FarahnazAzimi/Blue-Arm/Documentation/Blue_Arm_Report.pdf

به نام خداوند بخشنده ی مهربان

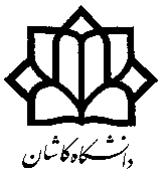
[picture p2: figure]

گزارش پروژه ی کارشناسی

## طراحی، ساخت و کنترل بازوی رباتیک

## مفصل سه درجه آزادی با قابلیت کنترل بی سیم (RRR(

Blue Arm project

- تهیه کننده : فرحناز عظیمی
- شماره دانشجویی : 40121010043
- تاریخ تحویل : 25 / /06 1405
- استاد راهنما : دکتر علیرضا فرجی
- راه ارتباطی از طریق ایمیل : com.gmail@222farahnazazimi
- راه ارتباطی از طریق ایتا : 222FARAHNAZAZIMI@

چکیده

این گزارش فرآیند طراحی، ساخت، کالیبراسیون و کنترل یک بازوی رباتیک مفصل سه درجه آزادی از نوع RRR را شرح میدهد . برخالف بسیاری از پروژه های مشابه که بر شبیه سازی تئوری تمرکز دارند این پروژه بر ساخت واقعی سخت افزار و کالیبراسیون تجربی با ابزار واقعی و چندین روش توسعه ی متفاوت سیمی و بی سیم ( wifi و Bluetooth )تمرکز دارد. بازو با سه سروو 995MG و یک گیرنده نهایی90SG ساخته شده و در نهایت به طور کامل توسط یک میکروکنترلر 32ESP کنترل میشود .معادالت سینماتیک معکوس و مستقیم استخراج شده و سپس با اندازه گیری دقیق ر وی ربات واقعی کالیبره شده اند تا خطای باقی مانده به حدود یک تا سه سانتی متر در عملیات برداشتن و گزاشتن (place and pick( واقعی برسد .بررسی

دینامیکی الگرانژی نیز توضیح میدهد که چرا مفصل شانه در وضعیت نزدیک به افقی بیشترین گشتاور را تجربه کند.

فهرست مطالب

چک ی ده 3 |
فصل 1 : مقدمه 6 |
فصل 2 : مرور ی بر منابع علم ی 7 |
فصل 3 : طراح ی و ساخت سخت افزار 9 |
فصل 4 : س ی نمات ی ک مستق ی م و معکوس 11 |
فصل 5 :تحل ی ل د ی نام ی ک ی به روش الگرانژ 18 |
فصل 6 : معمار ی نرم افزار ی و ارتباطات 23 |
23 | ۶.۱ firmware ESP32

فصل 7 : کال ی براس ی ون ، آزما ی ش و نتا ی ج 27 |
فصل 8 : چالش ها ی فن ی و روش ع ی ب ی اب ی 28 |
فصل :۹ نت ی جه گ ی ر ی و پ ی شنهاد ها 29 |
مراجع 30 |
آرش ی و تصاو ی ر 31 |

فصل 1 : مقدمه

### ۱.۱ انگیزه و اهمیت موضوع

بازوهای رباتیک مفصل یکی از پرکاربردترین انواع ربات در صنعت و آموزش هستند، زیرا فضای کاری بزرگ و انعطاف پذیری باالیی نسبت به حجم فیزیکی خود ارائه می دهند .ساخت یک نمونه کوچک و کم هزینه از این نوع ربات، فرصتی عملی برای درک عمیق مفاهیم سینماتیک، دینامیک، کنترل موتور و ارتباطات بی سیم فراهم می کند .

### ۱.۲ اهداف پروژه

- ساخت فیزیکی یک بازوی رباتیک سه درجه آزادی با سرووموتور
- استخراج و پیاده سازی معادالت سینماتیک مستقیم و معکوس
- کالیبراسیون واقعی ربات با اندازه گیری فیزیکی به جای اتکا صرف به مقادیر طراحی
- پیاده سازی سه روش کنترل ی مستقل: س یمی و بی س یم WiFi، و بلوتوث
- تحلیل دینامیکی برای درک نیاز گشتاوری هر مفصل
- رسیدن به قابلیت برداشتن و گذاشتن واقعی با دقت قابل قبول (Place and Pick(

### ۱.۳ ساختار گزارش

این گزارش با مروری بر پژوهش های مشابه آغاز می شود، سپس به ترتیب به طراحی سخت افزار، استخراج معادالت سینماتیک و دینامیک، معماری نرم افزاری و ارتباطات، فرآیند کالیبراسیون و آزمایش، چالش های فنی مواجه شده، و در نهایت نتیجه گیری و پیشنهادها می پردازد.

فصل 2 : مروری بر منابع علمی

پیش از آغاز ساخت، پژوهشهای مرتبط با بازوهای رباتیک سه درجه آزادی و روش های کنترل بی سیم آنها بررسی شد تا از تکراری نبودن مسیر و انتخاب رویکردهای معتبر اطمینان حاصل شود.

طهطاوی و آگن ی )۲۰۲۱( ی ک بازو ی رباتیک کوچک مقی اس سه درجه آزادی برا ی وظایف برداشتن و گذاشتن طراحی کردند که در آن معادالت س ینماتیک معکوس به صورت تحلیل ی استخراج و روی سخت افزار واقع ی پیادهسازی شده بود؛ نتایج آنها نشان داد که دقت موقع یت یابی به شدت به کالیبراس یون فیز یکی سرووها وابسته است، موضوعی که در پروژه حاضر نیز به وضوح تجربه شد

چن و همکاران )2025( در نشریه ی sensors یک بازو ی رباتیک دوتایی کم هز ینه با پیکربند ی سه درجه ازادی معرف ی کردند که تمرکز اصلی آن بر استفاده از قطعات ارزان قیمت بدون افت چشمگ یر دقت عملکردی بود رویکرد ی که با انتخاب سرووهایی 995MG و 90SG در این پروژه هم راستا هستند .

منتشر شده، یک بازوی برداشتن و گذاشتن مبتنی بر (۲۰۲۴) ResearchGate در پژوهشی دیگر که در سروو با تمرکز بر پیاده سازی عملی سینماتیک معکوس بررسی شده است که مشابه رویکرد فصل چهارم این برای بازوی دو پیوندی استفاده می کند (Cosines of Law (گزارش، از روش حل مثلثاتی .

در مقاله »طراحی بازوی ربات ی ک سه درجه آزاد ی« ) ۲۰۱۸(، فرمان و همکاران یک بازو ی مفصل صنعتی را با تمرکز بر انتخاب موتور بر اساس تحلیل گشتاور طراحی کردند؛ نتی جه گیری آن ها که »بی شترین گشتاور مورد نیاز موتور شانه در وضعیت افقی رخ می دهد« دقی قاً با یافته های فصل پنجم این گزارش )تحل یل دینامیک الگرانژ( و همچنین با تجربه واقعی خراب ی سروو شانه در ای ن پروژه هم خوانی دارد.

پاولوی و همکاران )۲۰۲۴( پی اده سازی کنترل یک بازوی رباتیک چهار درجه آزاد ی از طریق 32ESP و بلوتوث را گزارش کرده اند . این پژوهش به طور مستق یم مرتبط با فصل ششم این گزارش است، زیرا هر دو پروژه از 32ESP به عنوان واحد کنترل بی س یم بدون نیاز به رایانه واسط استفاده م ی کنند، هرچند در این پروژه عالوه بر بلوتوث، ارتباط WiFi و ی ک صفحه وب کنترلی نی ز اضافه شده است.

### ۲.۱ جمع بندی و جایگاه این پروژه

مرور منابع نشان می دهد که چالشهای اصلی این نوع پروژه ها )کالیبراس یون ف یزیکی، انتخاب مناسب موتور بر اساس گشتاور، و پیاده سازی ارتباط بی س یم پایدار( موضوعاتی شناخته شده در ادبیات هستند . نقطه تمایز این پروژه، ترکیب هر سه روش ارتباطی )س یمی، WiFi، بلوتوث( در یک س یستم واحد و مستند سازی کامل فرآیند کال یبراس یون تجربی گام به گام است.

فصل 3 : طراحی و ساخت سخت افزار

### ۳.۱ اجزای اصلی

نقش مشخصات قطعه

چرخش پایه حول محور عمودی 995MG سروو پایه

باال و پایین بردن بازوی باالیی 995MG سروو شانه

خم کردن ساعد نسبت به بازوی باالیی 995MG سروو آرنج

باز و بسته کردن گیرنده 90SG سروو گیرنده

تغذیه پایدار سرووها با جریان کافی (ATX (پاور کامپیوتر ۳۵۰ وات منبع تغذیه

کنترل مستقل بدون نیاز به رایانه (Bluetooth + WiFi (32ESP واحد کنترل

### ۳.۲ تکامل معماری سخت افزاری

در ابتدای پروژه از یک آردوینو uno برا ی کنترل مستق یم سرووها استفاده شد و 32ESP صرفاً به عنوان پل ارتباطی WiFi عمل می کرد. پس از آزمایش، مشخص شد که سرووهای معمولی )از جمله 995MG )با ولتاژ منطق ی ۳.۳ ولت 32ESP نیز به درستی کار می کنند، بنابراین آردوینو به طور کامل حذف شد و 32ESP به تنهایی مسئولی ت تولید س یگنال PWM برای هر چهار سروو، میزبانی صفحه وب، و مد یریت ارتباط بلوتوث را بر عهده گرفت. این تصمی م پیچیدگ ی س ی ستم را کاهش داد و امکان تغذ یه کامل ربات از یک منبع واحد )بدون نیاز به رایانه( را فراهم کرد. نکته ی مهم این است که با وجود سرووی چهارم، ربات ۴ درجه آزادی نیست.
* تعر یف درجه آزاد ی در بازو : درجات آزاد ی یک بازو ی رباتیک )Manipulator )بر اساس تعداد مفاصل مستقلی تعیین می شود که موقعیت )z ,y ,x )و جهت گیر ی ابزار را در فضای کاری مشخص می کنند .

* نقش سرووی چهارم: سه سرووی اول )پایه، شانه و آرنج( وظی فه جا به جایی و قرار دادن نوک بازو در مختصات مورد نظر را بر عهده دارند .

* حرکت پنجه/گیرنده یک حرکت داخلی برای ابزار نهایی )Effector End )است و مفصل جد ید ی به زنجیره س ینماتیکی اصلی بازو برای تغییر موقعیت در فضا اضافه نمی کند .

### ۳.۳ مسئله ی ظرفیت جریان برد بورد

در حین آزمایش هم زمان هر چهار سروو، مفصل شانه دچار ضعف و لرزش غیرمنتظره شد . بررس ی گام به گام نشان داد که علت اصلی، ظرفیت جریان محدود اتصاالت برد بورد بود، نه مشکلی در خود سروو یا کد؛ هر تماس فنری برد بورد معموالً ظرفیت قابل اطمینانی در حدود ۱ آمپر دارد که برای تغذ ی ه هم زمان چند سروو کافی نیست. راه حل نهایی، انتقال کامل مسیر تغذ یه به ی ک برد سوراخ دار لحیم شده )Perfboard )بود که مقاومت مسیر را به شدت کاهش داد.

### ۳.۴ تغذیه ی پایدار

منبع تغذ یه ATX با استفاده از روش اتصال کوتاه پایه ON_PS به زمین فعال شد . ولتاژ خروجی ۵ ولت با استفاده از ی ک LED و مقاومت به صورت تجربی تأیید شد و در نهایت یک خازن الکترولیتی بزرگ )۲۲۰۰ میکروفاراد( برا ی کاهش افت لحظه ای ولتاژ هنگام حرکت هم زمان چند سروو اضافه شد .

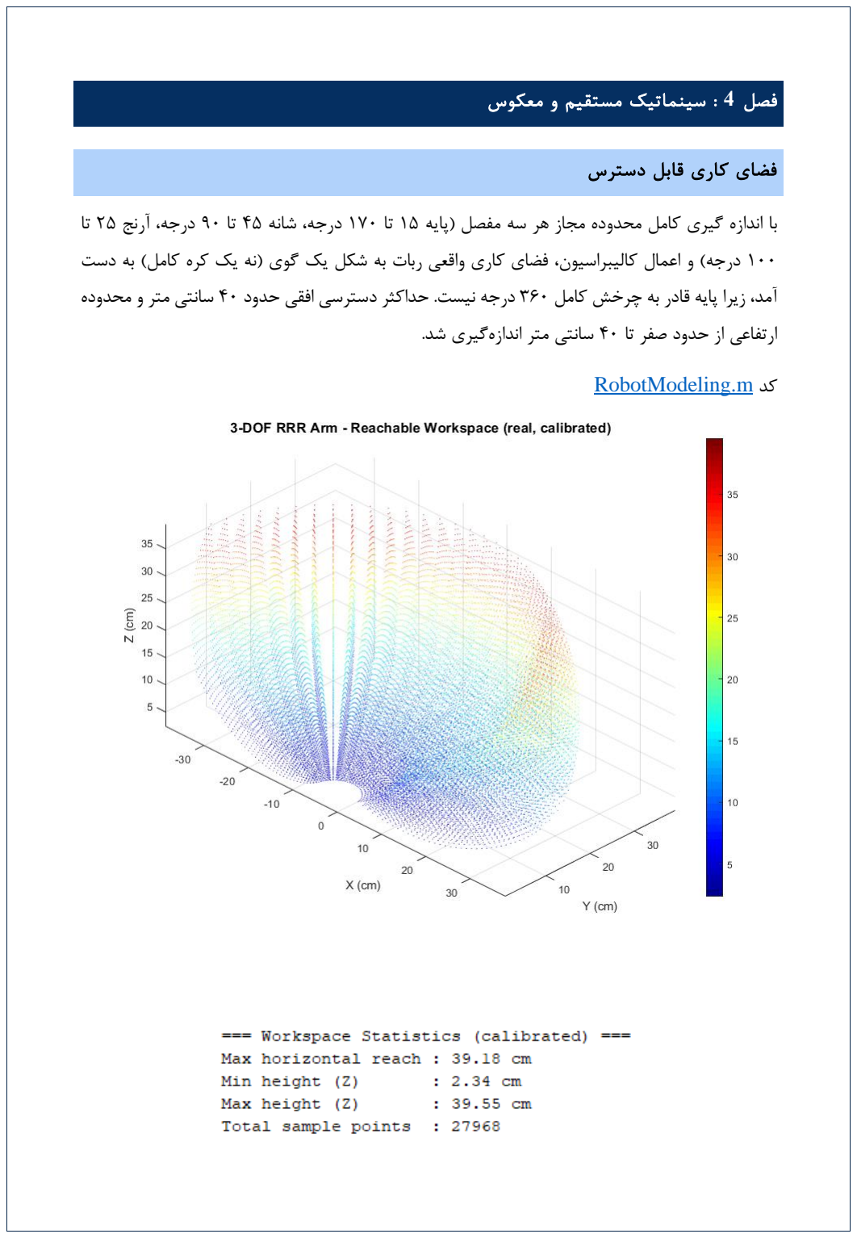
[picture p3: page 11]

فصل 4 : سینماتیک مستقیم و معکوس

فضای کاری قابل دسترس

با اندازه گیری کامل محدوده مجاز هر سه مفصل )پایه ۱۵ تا ۱۷۰ درجه، شانه ۴۵ تا ۹۰ درجه، آرنج ۲۵ تا ۱۰۰ درجه( و اعمال کالیبراس یون، فضای کاری واقعی ربات به شکل یک گو ی )نه ی ک کره کامل( به دست آمد، زی را پای ه قادر به چرخش کامل ۳۶۰ درجه نیست. حداکثر دسترس ی افقی حدود ۴۰ سانتی متر و محدوده ارتفاعی از حدود صفر تا ۴۰ سانتی متر اندازه گیری شد .

RobotModeling.m کد

### ۴.۱ پارامتر های هندسی واقعی

اندازه گیری مستقیم رو ی ربات ساخته شده )نه مقادیر طراحی اولیه ( برای دقت مدل ضروری بود، ز یرا براکت ها، شاخک سرووها و نگه دارنده گیرنده همگ ی طول واقعی بیشتری نسبت به طرح کاغذ ی ایجاد می کنند .

مقدار پارامتر

سانتی متر ۵ ارتفاع پایه از زمین

سانتی متر ۸ (پایه تا شانه) 1L

سانتی متر ۲۱ (شانه تا آرنج) 2L

سانتی متر ۲۸ )آرنج تا نوک گیرنده ( 3L

### DH parameter table

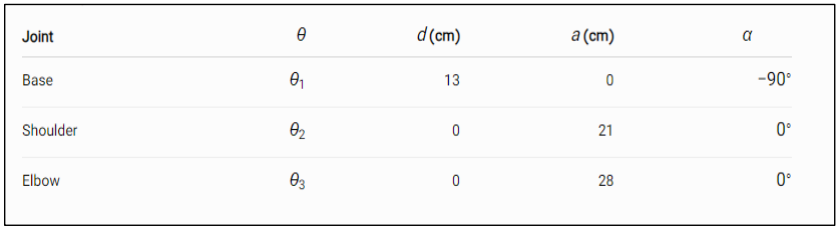
[picture p4: figure]

۴.۲ سینماتیک مستقیم (KINEMATICS FORWARD(

با استفاده از پارامترهای دناویت-هارتنبرگ ) DH )و همچنین معادالت بسته فرم مثلثاتی، موقعیت نوک گیرنده بر اساس زوایای مفاصل محاسبه می شود. قرارداد زاویه ای انتخاب شده به شرح زیر است:

- θ۱( پایه(: چرخش حول محور عمودی
- θ۲( شانه(: زاویه نسبت به افق
- θ۳( آرنج(: زاویه نسبی نسبت به بازوی باالیی )نه زاویه مطلق(

قرارداد زاویه نسبی آرنج از طریق آزمایش فیزیکی تأیید شد: با ثابت نگه داشتن شانه در دو زاویه مختلف و اندازه گیری زاویه واقعی ساعد با گونیا، مشخص شد که تغییر زاویه ساعد هم زمان با تغییر شانه جابه جا می شود، که این رفتار مشخصه یک مفصل نسبی است نه مطلق.

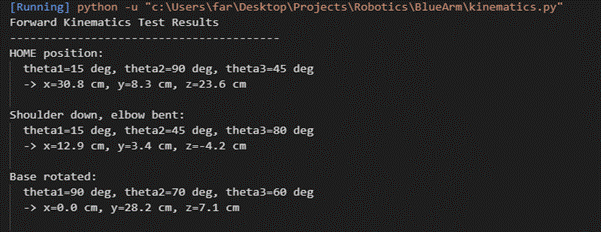
[picture p5: figure]

۴.۳ سینماتیک معکوس (KINEMATICS INVERSE(

برای یافتن زوایای الزم جهت رس یدن به ی ک نقطه هدف )z ,y ,x)، از روش حل مثلث ی بازوی دو پیوند ی ) قانون کسینوس ها( استفاده شد . این روش، زاویه داخلی آرنج را از روی فاصله مستقیم تا هدف محاسبه کرده و سپس زاویه شانه را با ترکیب زاوی ه مسیر مستق یم و زاویه کمکی به دست می آورد. الگوری تم پ یش از استفاده با ی ک آزمون رفت وبرگشت ) Test Trip-Round )اعتبارسنج ی شد : زوایای دلخواه ابتدا به یک موقعیت تبد یل شدند و سپس همان موقعیت مجدداً به زوایا بازگردانده شد؛ خطای این آزمون در حد ۰.۰۰۰۰۰۱ سانتی متر بود که نشان دهنده صحت ری اضی کامل معادالت است.

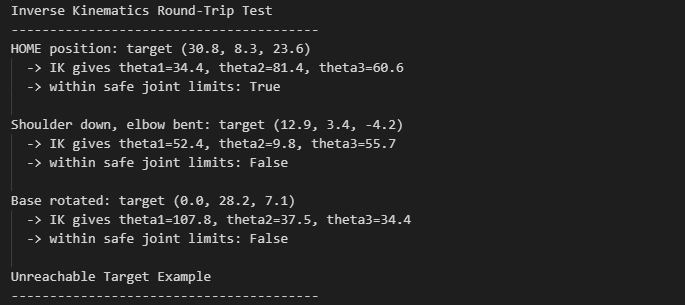
[picture p6: figure]

kinematics.py کد

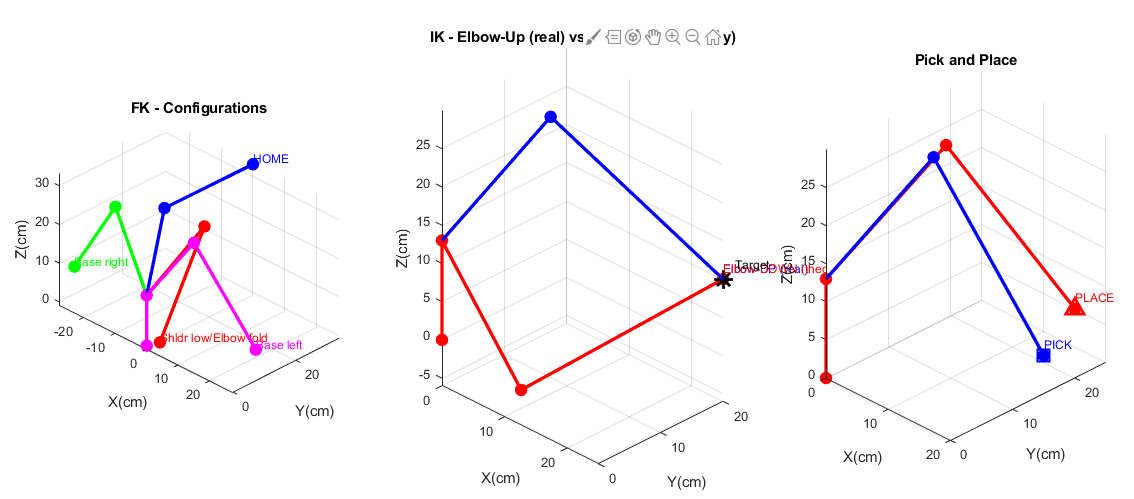
[picture p7: figure]

Kinematics_FK_IK.m کد

### Transformation matrices

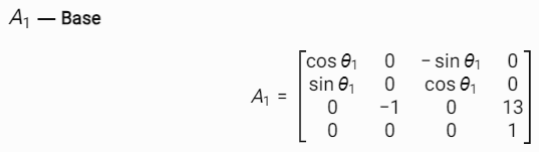
[picture p8: figure]
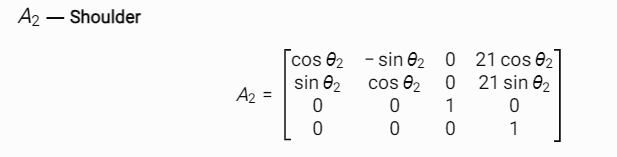
[picture p9: figure]
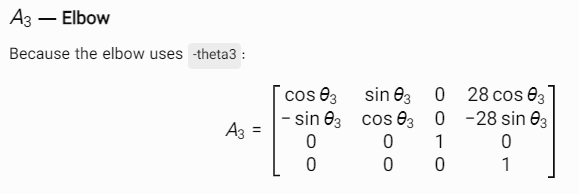
[picture p10: figure]

### Forward kinematics (FK)

T03 = A1 A2 A3 =

### end-effector position

### Inverse Kinematics (IK)

زاویه ی پایه :

فاصله ی افقی از پایه:

فاصله ی هدف از بازو:

برای قابل دسترس بودن :

برای این ربات :

### ۴.۴ کالیبراسیون تجربی

با وجود صحت ریاضی معادالت، اولین آزمایش رو ی ربات واقعی نشان داد که موقعیت واقعی گیرنده با موقعیت پیش بینی شده تا حدود ۹ تا ۱۰ سانتیمتر تفاوت دارد. علت این تفاوت، عدم تطابق دقی ق زاوی ه فرمانی سروو با زاویه واقعی مکانیکی مفصل بود )ناش ی از نحوه نصب شاخک سروو(. با اندازه گیر ی مستق یم زاویه واقعی توسط گونیا در چند نقطه مشخص و برازش خط ی، مقادی ر جبرانی زیر به دست آمد :

مقدار پارامتر جبرانی

درجه ۱۵.۵ جبران زاویه شانه

درجه ۴۹.۷ جبران زاویه آرنج

سانتی متر -۵ X تصحیح موقعیت

سانتی متر +۴ Y تصحیح موقعیت

سانتی متر -۷ Z تصحیح موقعیت

پس از اعمال این تصحیحات، خطای موقعیت یابی در آزمایشهای واقعی برداشتن-گذاشتن به حدود ۲ تا ۳ سانتی متر کاهش یافت که برای وظایف عملی این ربات قابل قبول ارزیابی شد .

فصل 5 :تحلیل دینامیکی به روش الگرانژ

### ۵.۱ هدف تحلیل

در حالی که سینماتیک مشخص می کند ربات کجا قرار دارد، دینامیک مشخص می کند هر موتور برای نگه داشتن یا حرکت دادن بازو به چه میزان گشتاور نیاز دارد .این تحلیل به طور مستقیم یک مشکل واقعی این پروژه را توضیح می دهد :سروو شانه در وضعیت نزدیک به افقی دچار فشار مکانیکی شد و نیاز به تعویض پیدا کرد.

روش 5.2

با استفاده از مکانیک الگرانژی، انرژی جنبشی و پتانسیل هر پیوند بر اساس مرکز جرم آن محاسبه و معادله حرکت استاندارد رباتیک به دست آمد :

M(q)·q̈ + C(q,q̇)·q̇ + G(q) = τ

که در آن M ماتریس اینرسی، C ماتریس کوریولیس/گریز از مرکز، G بردار گشتاور گرانشی، و τ گشتاور مورد نیاز هر مفصل است. از آنجا که این بازو با سرعت پایین حرکت می کند، مؤلفه گرانشی (G (نقش غالب را ایفا می کند .

جرمهای تخمینی ربات به شکل زیر در نظر گرفته شده اند :

- m1 = 0.500 kg
- m2 = 0.300 kg
- m3 = 0.250 kg

با این جرم ها، بیشترین گشتاور موردنیاز مربوط به مفصل شانه (2θ (است

بنابراین بدترین حالت در 20° = 2θ اتفاق می افتد

τ2 = 11.1823 kg·cm

در حالی که گشتاور نامی سروو 995MG برابر cm·kg 11 در نظر گرفته شده است

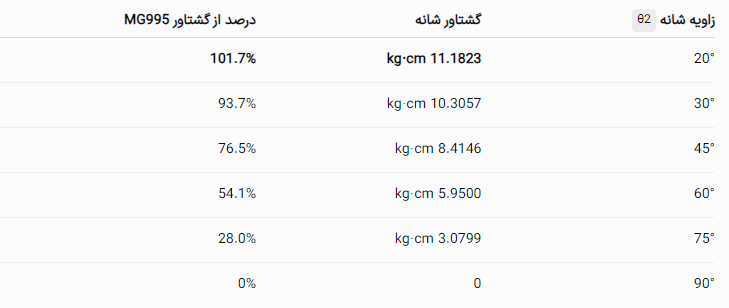
[picture p11: figure]

برای این پروژه می توانیم یک مدل ساده و قابلدفاع برای رابطه ی Speed–Torque سرووی 995MG تعریف کنیم. نکته مهم این است که چون دیتاشیت 995MG معموالً منحنی کامل Speed–Torque نمیدهد، این مدل مدل تخمینی مهندسی است، نه منحنی رسمی سازنده.

بنابراین سرعت بدون بار از رابطه زیر به دست می آید :

پس مدل ما می شود:

θ2 | Torque kg.cm | Torque / MG995 | تخمینی | سرعت
20° | 11.1823 | 101.7% | 0°/s → Overload
25° | 10.7851 | 98.0% | 7.3°/s
30° | 10.3057 | 93.7% | 23.7°/s
35° | 9.7479 | 88.6% | 42.7°/s
40° | 9.1159 | 82.9% | 64.2°/s
45° | 8.4146 | 76.5% | 88.2°/s
50° | 7.6492 | 69.5% | 114.3°/s
55° | 6.8256 | 62.1% | 142.3°/s
60° | 5.9500 | 54.1% | 172.2°/s
65° | 5.0292 | 45.7% | 203.5°/s
70° | 4.0700 | 37.0% | 236.3°/s
75° | 3.0799 | 28.0% | 270.0°/s
80° | 2.0664 | 18.8% | 304.6°/s
85° | 1.0372 | 9.4% | 339.7°/s
90° | 0 | 0% | 375°/s

۵.۳ نتیجه ی کلیدی :گشتاور پایه صفر است.

محاسبات نشان داد که ردیف اول بردار G( مربوط به مفصل پایه( همواره برابر صفر است. این نتی جه اثبات شده )نه فرض شده( است: چرخش پایه تنها جهت بازو را در صفحه افق ی تغییر می دهد و ارتفاع هیچ یک از پی وندها را تغییر نمی دهد، بنابراین گرانش هیچ گشتاور ی بر آن اعمال نمی کند . این یافته با مشاهده عملی هم خوانی کامل دارد: سروو پایه در طول پروژه هرگز دچار فشار یا خرابی نشد .

### ۵.۴ گشتاور شانه و آرنج

اندازه گیری زاوی ه شانه از ۲۰ تا ۹۰ درجه نشان داد که بیشترین گشتاور مورد نیاز دقی قاً در نزدیکی افق ی ترین حالت )نزدیک به ۲۰ درجه( رخ می دهد و با نزدیک شدن به حالت عمودی ) ۹۰ درجه(، گشتاور مورد نیاز به شدت کاهش مییابد . این نتیجه به طور کامل با یافته های تجربی اولی ه پروژه )پیش از انجام هرگونه تحلیل ریاضی( مطابقت دارد، جایی که آزمایش دستی نشان داده بود سروو شانه در زوایای پایین دچار مشکل می شود.

بر اساس این تحلیل، مقدار گشتاور مورد ن یاز شانه در بدتر ین حالت به عنوان درصد ی از گشتاور نامی سروو 995MG( ۱۱ ک یلوگرم-سانت یمتر( محاسبه و مقایسه شد تا حاش یه ایمن ی طراحی مشخص شود.

### ۵.۵ محدودیت مدل

جرم هر پیوند ) m،۱ m،۲ m۳ )در این تحلیل بر اساس تخمین وارد شده است، نه وزن کش ی دقیق. برای گزارش نهایی با دقت کامل، توصیه می شود هر پی وند به همراه سروو و براکت های خود با ترازو وزن کشی و مقادیر جایگزین شوند . با این حال، الگوی کلی نتایج )اینکه بیشترین گشتاور کجا رخ می دهد ( مستقل از دقت جرمها معتبر باقی می ماند .

Dynamics_Lagrange.m کد

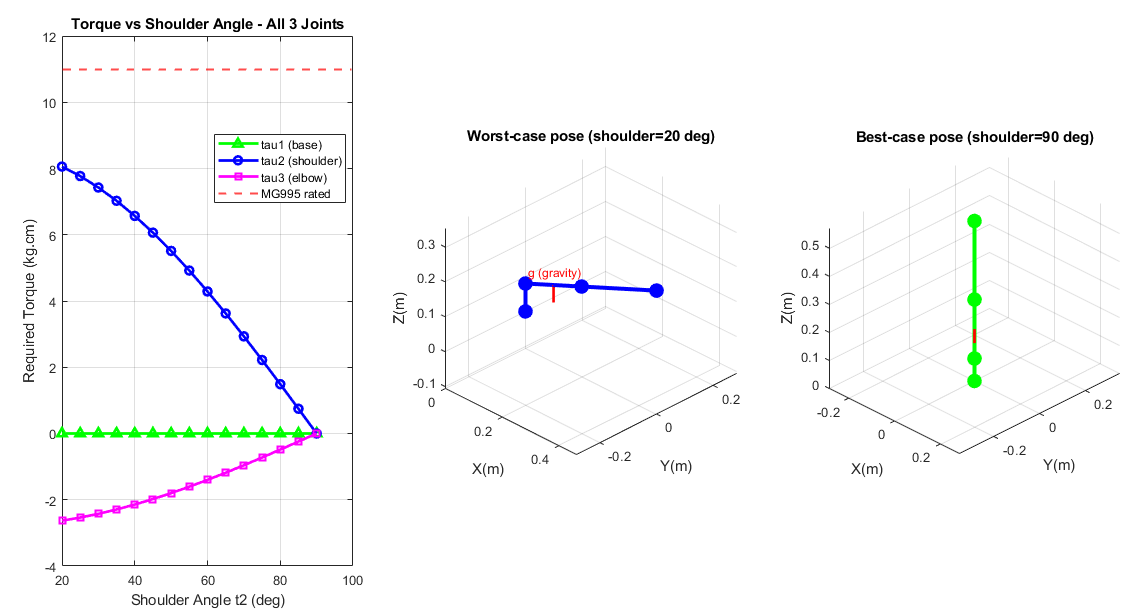
[picture p12: figure]

فصل 6 : معماری نرم افزاری و ارتباطات

### ۶.۱ firmware ESP32

فریمور نهایی به طور کامل روی 32ESP اجرا م ی شود و شامل کنترل نرم و تدریجی هر سروو )یک درجه در هر گام زمانی کوتاه، برای جلوگیری از حرکت ناگهانی و آس یب مکانیکی(، محدودیت های ایمنی زاویه ای هر مفصل، موقعیت خانه )HOME )ایمن هنگام روشن شدن، و قابلیت گزارش موقعیت واقعی لحظه ای است.

esp32_standalone_firmware.ino کد

### ۶.۲ سه روش کنترلی مستقل

کاربرد اصلی فناوری روش

توسعه، اشکال زدایی، اسکریپت پایتون ارتباط سریال با نرخ ۱۱۵۲۰۰ (USB (سیمی

کنترل از طریق مرورگر هر دستگاه، بدون نیاز HTTP صفحه وب + 32ESP نقطه دسترسی WiFi بیسیم به نصب برنامه

برنامه اختصاصی اندروید ساخته MIT شده با(BluetoothSerial (بلوتوث کالسیک بلوتوث App Inventor

نکته طراحی مهم: هر سه روش از یک قالب فرمان یکسان استفاده م ی کنند )شناسه مفصل + سه رقم زاویه، مانند »۱۰۹۰« برا ی فرمان مفصل شماره ۱ به زاوی ه ۹۰ درجه(، به طوری که منطق پردازش فرمان تنها یک بار نوشته و توسط هر سه کانال ارتباطی به اشتراک گذاشته می شود. این رویکرد از تکرار کد و ناهماهنگ ی احتمالی بین روش های مختلف جلوگی ری می کند .

کد آردویینو ino.maincc

### ۶.۳ رابط کاربری وب

صفحه وب میزبانی شده رو ی 32ESP شامل چهار اسالیدر )برا ی هر مفصل(، دکمه بازگشت به وضعیت خانه، و بخش برداشتن- گذاشتن با اعتبارسنجی زنده است؛ به ای ن معنا که هرگاه کاربر مختصات )z ,y ,x )را وارد می کند، صفحه بالفاصله )بدون نیاز به ارسال فرمان( با استفاده از همان معادالت س ینماتیک معکوس )نوشته شده به زبان جاوا اسکریپت( بررس ی می کند که آ یا آن نقطه در محدوده مجاز است، و پ یام »قابل دسترس« یا »غیر قابل دسترس« را فوراً نمایش می دهد .

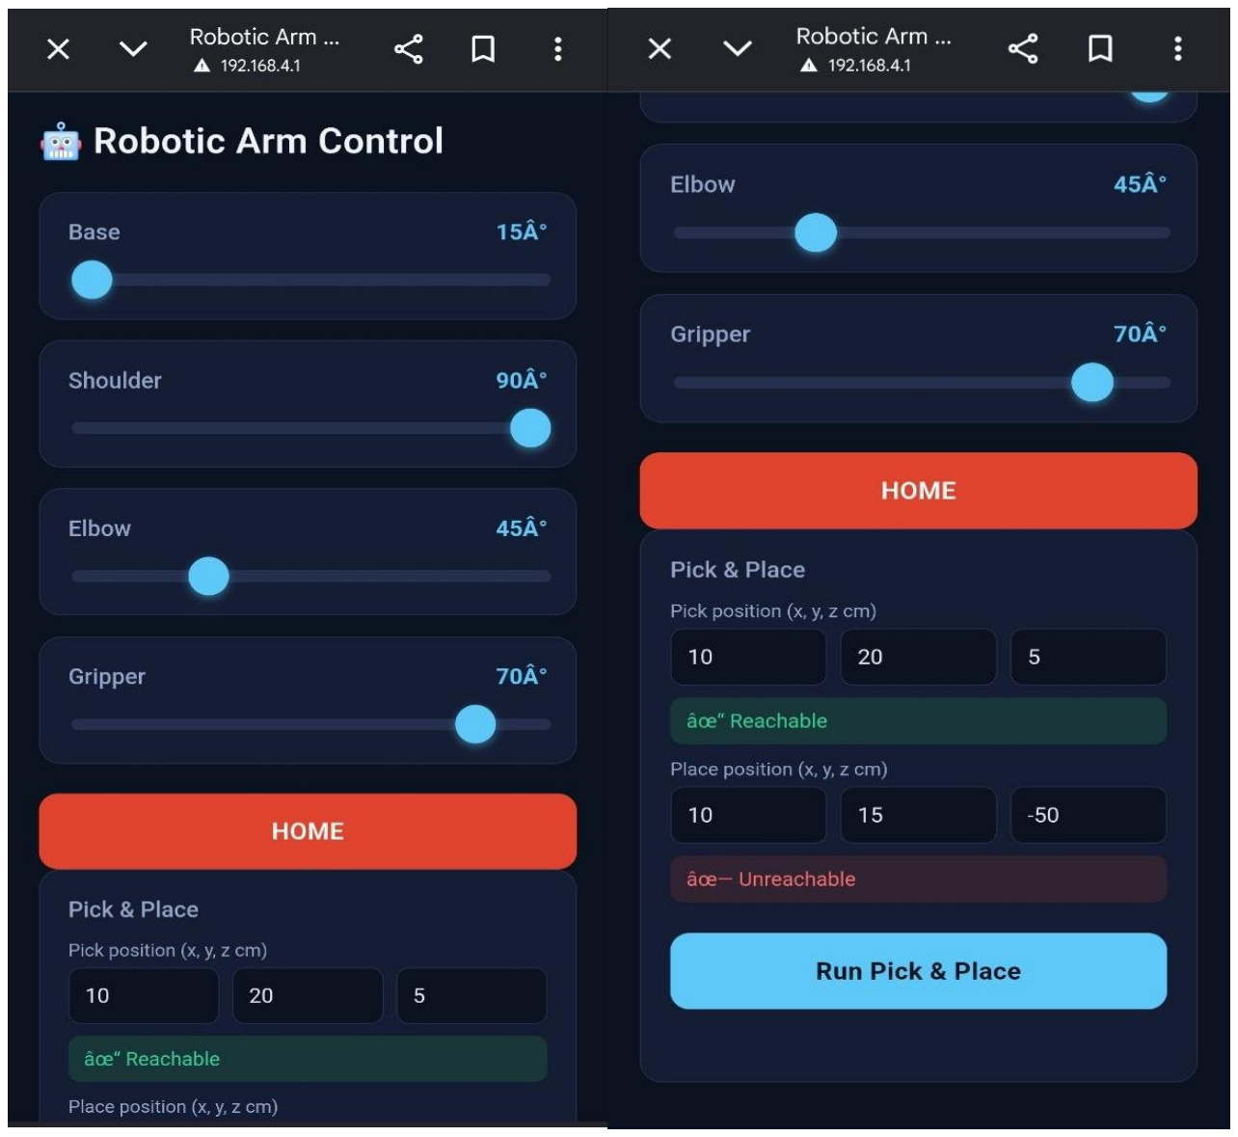
[picture p13: figure]

(MIT APP INVENTOR) | اندروید | برنامه | ۶.۴

برنامه موبایل با استفاده از پلتفرم بلوکی Inventor App MIT ساخته شد که امکان توسعه سریع بدون نیاز به کد نویسی جاوا را فراهم م یکند . این برنامه شامل اتصال بلوتوث کالس یک، چهار اسالیدر متناظر با مفاصل، دکمه خانه، و بخش برداشتن-گذاشتن با ارسال مختصات خام است که پردازش س ینمات یک معکوس آن ها به طور کامل روی 32ESP( نه روی گوش ی( انجام می شود؛ این تصمیم طراحی از پیاده سازی محاسبات مثلثاتی پیچیده در محیط بلوکی اجتناب کرد.

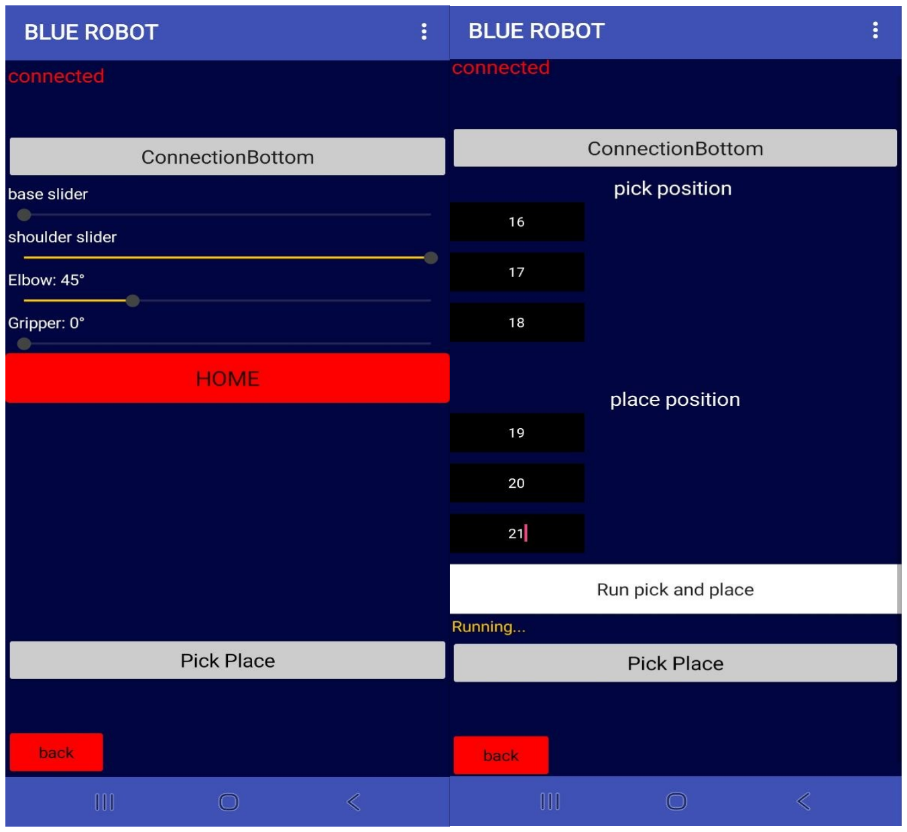
[picture p14: figure]

MIT App Inventor.html کد

### ۶.۵ ابزار های پایتون

دو نسخه از رابط کنترل ی پایتون ساخته شد : یکی مبتنی بر ارتباط سریال USB و د یگری مبتنی بر درخواستهای HTTP از طری ق WiFi، که هر دو از کتابخانه س ینماتیک مشترک )py.kinematics )برای محاسبه زوایا از روی مختصات هدف استفاده می کنند .

servo_test_gui_wifi.py کد

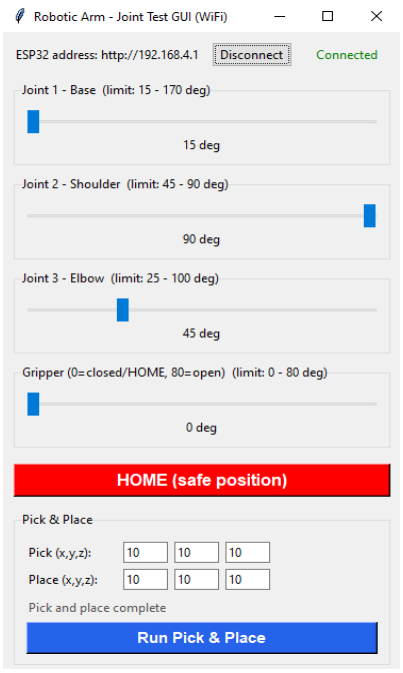
[picture p15: figure]

فصل 7 : کالیبراسیون ، آزمایش و نتایج

### ۷.۱ روش اندازه گیری

برای اندازه گیر ی دقیق موقعی ت واقعی نوک گریپر، یک س ی ستم مختصات مرجع روی می ز کار ای جاد شد : محور Y با قرار دادن پایه در زاویه ۹۰ درجه و رسم خط مستق ی م در جهت اشاره بازو مشخص شد، و محور X به صورت عمود بر آن رسم گردی د . برای یافتن موقعیت افقی هر نقطه، از روش شاقول )آوی زان کردن وزنه از نوک گیرنده تا سطح م یز( استفاده شد .

### ۷.۲ نتایج کالیبراسیون گام به گام

فرآیند کال یبراس یون به صورت تکراری انجام شد : ابتدا خطای اولیه حدود ۹ تا ۱۰ سانتیمتر )عمدتاً در راستای ارتفاع( شناسایی شد . با اندازه گیری مجدد طول واقعی پیوندها )که با مقادیر طراحی اول یه تفاوت داشتند ( و سپس یافتن افست های زاوی ه ای از طریق آزمایش مستقی م با گونیا، خطا به تدریج کاهش یافت. در نهایت، افزودن یک تصحیح موقعیت ی تجربی )بر اساس مقایسه مستقیم موقع یت پیش بینی شده و واقع ی( خطای نهایی را به حدود ۲ تا ۳ سانتیمتر رساند .

### ۷.۳ آزمایش برداشتن _گزاشتن واقعی

توالی کامل برداشتن - گذاشتن )رفتن به باالی جسم، پایینآمدن، بستن گیرنده ، باالرفتن، جا به جایی به مقصد، پایین آمدن، باز کردن گیرنده ، بازگشت به خانه( با موفقیت روی اجسام کوچک واقعی آزمایش شد . سرعت حرکت هر مفصل نیز پس از چند دور بهینه سازی از یک گام آهسته اولی ه ) ۱۵ میلی ثانیه بر درجه، برای ایمنی در برابر فشار مکانیکی( به یک مقدار نزدیک به آنی )۱ می لی ثانیه بر درجه( کاهش یافت، در حالی که همچنان حرکت گام به گام )نه جهش ناگهانی( حفظ شد تا خطر آس یب به سروو در وضعیت های پرفشار از بین نرود.

فصل 8 : چالش های فنی و روش عیب یابی

در طول این پروژه چندین مشکل واقعی مواجه و با رویکرد سیستما تیک حل شد .مهم ترین آن ها در جدول زیر خالصه شده است:

| | راهحل علت ریشه ای مشکل
| | | انتقال به برد لحیم شده ظرفیت جریان محدود بردبورد ضعف مفصل شانه با ۴ سروو
| | تعویض سروو سروو معیوب (تأیید با تعویض( خرابی سروو شانه
عدم دریافت داده روی Arduino از ESP32 | تداخل کتابخانه SoftwareSerial با کتابخانه Servo | | استفاده از NeoSWSerial
| توقف زودهنگام حلقه انتظار پیش از گیرنده فقط تا حدی باز می شد رسیدن گریپر به هدف | | افزودن شرط انتظار مخصوص گریپر
| ارسال درخواست های HTTP مواز ی اتصال بی سیم مکرر قطع می شد متعدد هنگام کشیدن اسالیدر | محدودسازی به یک درخواست فعال در هر زمان

فصل :۹ نتیجه گیری و پیشنهاد ها

### ۹.۱ دستاورد های پروژه

- ساخت کامل یک بازوی رباتیک سه درجه آزادی با سخت افزار پایدار و تغذیه مستقل
- استخراج، پیاده سازی و کالیبراسیون معادالت سینماتیک مستقیم و معکوس با دقت نهایی ۲ تا ۳ سانتیمتر
- تحلیل دینامیکی که به طور مستقیم یک مشکل واقعی مکانیکی را توضیح داد
- با پروتکل فرمان مشترک (بلوتوث ،WiFi ،سیمی) سه روش کنترلی مستقل و کامالً کاربردی
- قابلیت کامل برداشتن-گذاشتن خودکار از طریق مختصات دلخواه

### ۹.۲ محدودیت ها

- جرم پیوندها در تحلیل دینامیکی بر پایه تخمین است، نه وزن کشی دقیق
- خطای باقی مانده ۲ تا ۳ سانتیمتر برای برخی وظایف ظریف ممکن است کافی نباشد

۹.۳پیشنهاد برای کار های آینده

- وزن کشی دقیق هر پیوند برای افزایش دقت تحلیل دینامیکی
- افزودن بازخورد بصر ی )دوربی ن( برای اصالح خودکار خطا ی موقعیت یابی
- طراحی و چاپ سه بعدی محفظه نهایی برای ظاهر و مقاومت بهتر

مراجع

Tahtawi, A. R., & Agni, D. (2021). Small-scale robot arm design with pick and place mission based on inverse kinematics. Journal of Robotics and Control (JRC).

Chen, X., et al. (2025). Low-cost 3-DOF dual-arm robotic manipulator design and evaluation. Sensors, MDPI.

ResearchGate (2024). Design and implementation of a servo-based 3-DOF pick and place robotic arm.

Farman, et al. (2018). Design of a three degree of freedom robotic arm.

Pawelloi, et al. (2024). ESP32 and Bluetooth-based control of a 4-DOF robotic arm.

آرشیو تصاویر

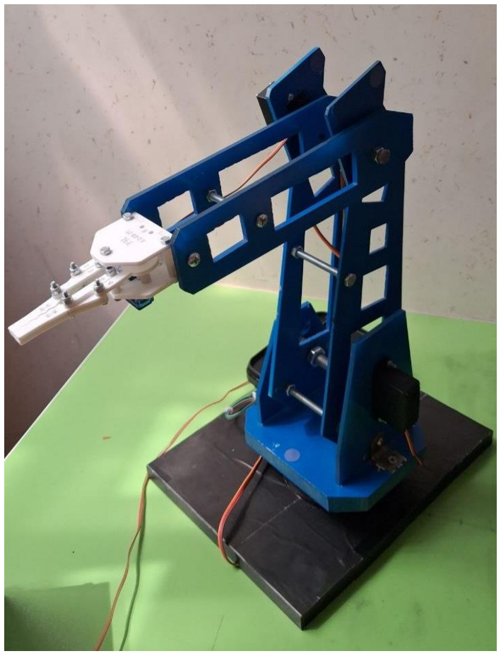
[picture p16: figure]

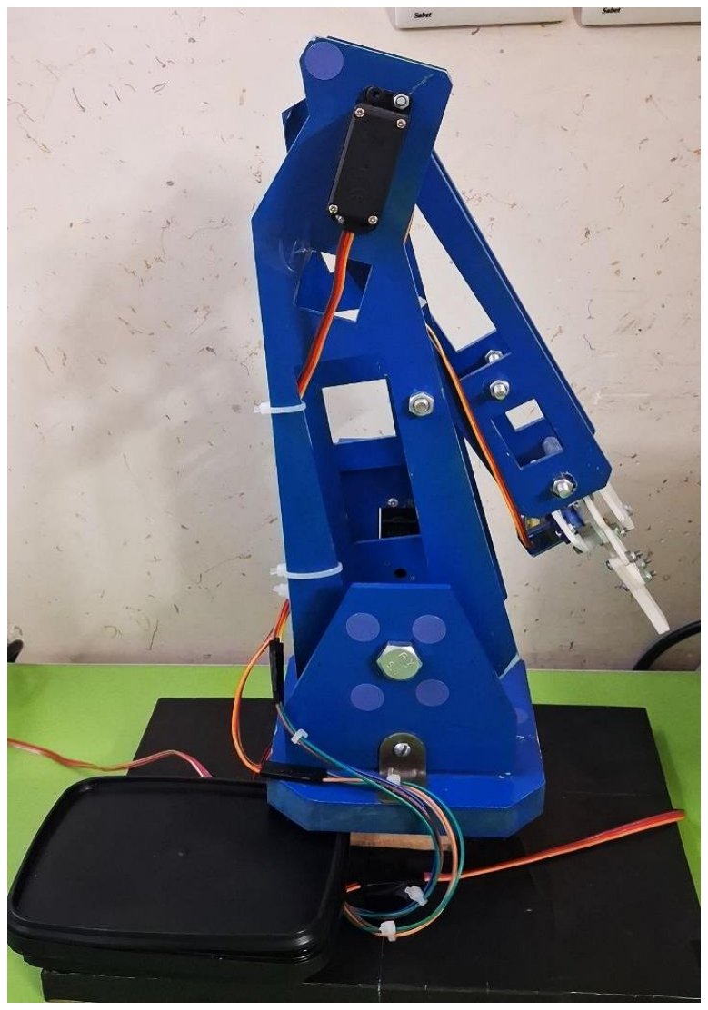
[picture p17: figure]
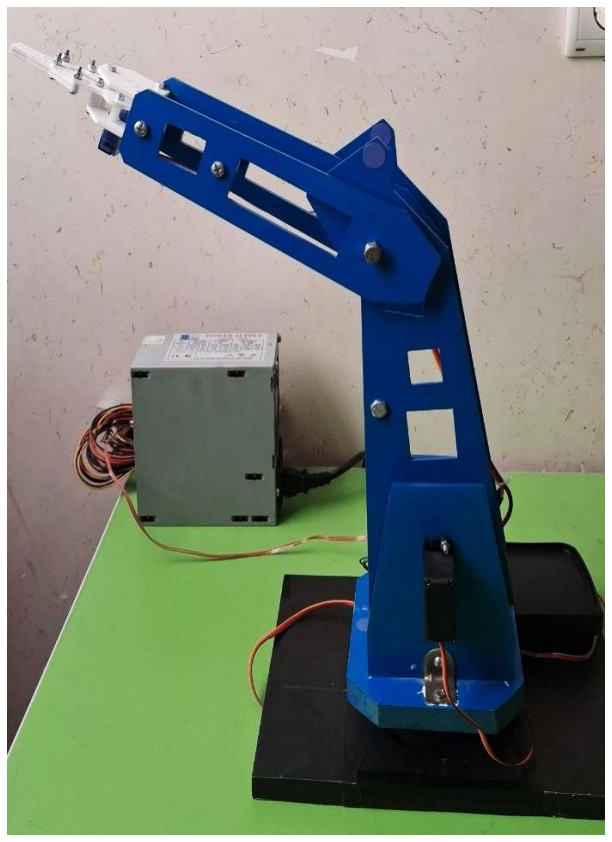
[picture p18: figure]
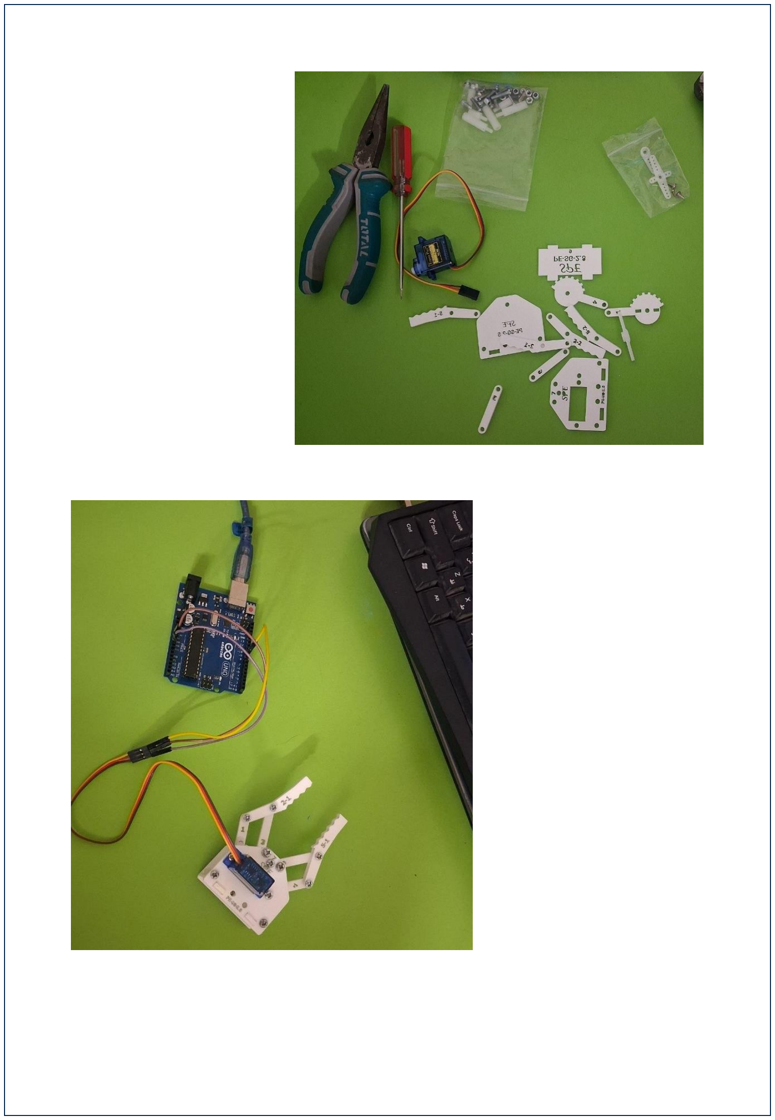
[picture p19: page 33]
