FarahnazAzimi/Blue-Arm/Documentation/Annotation 2026-09-15 135113.png

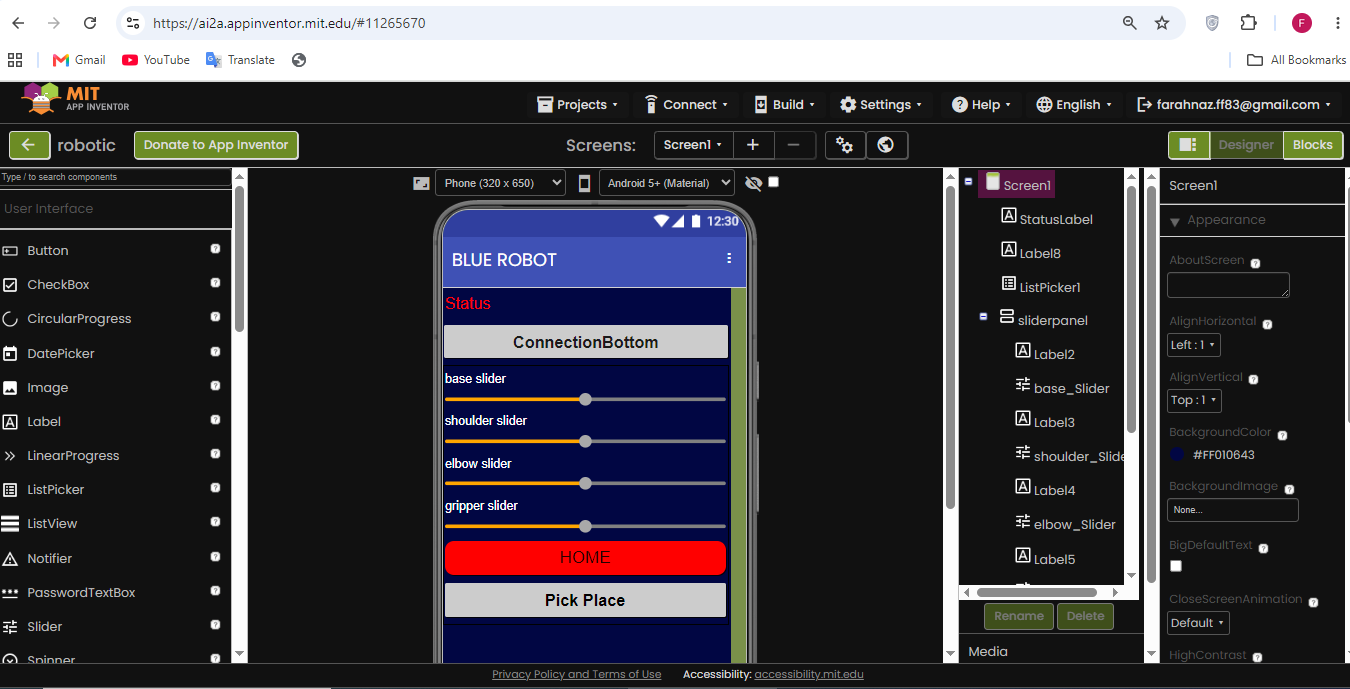
Documentation/Annotation 2026-09-15 135113.png
