FarahnazAzimi/Blue-Arm/Documentation/photo_2026-09-11_12-02-27.jpg

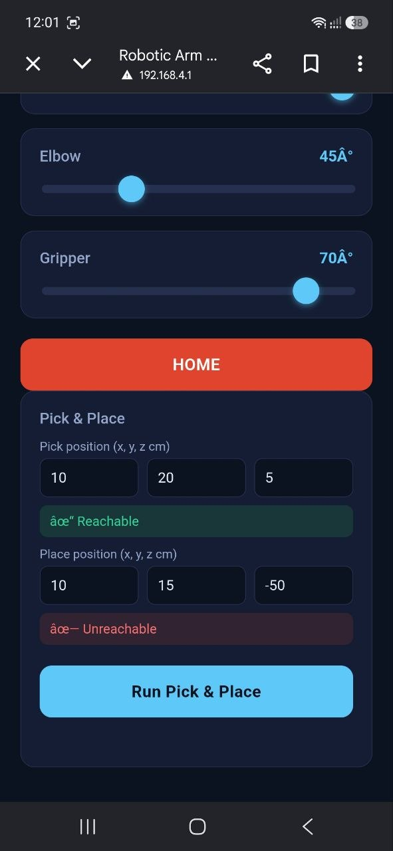
Documentation/photo_2026-09-11_12-02-27.jpg
