FarahnazAzimi/Blue-Arm/Documentation/photo_2026-09-11_12-02-32.jpg

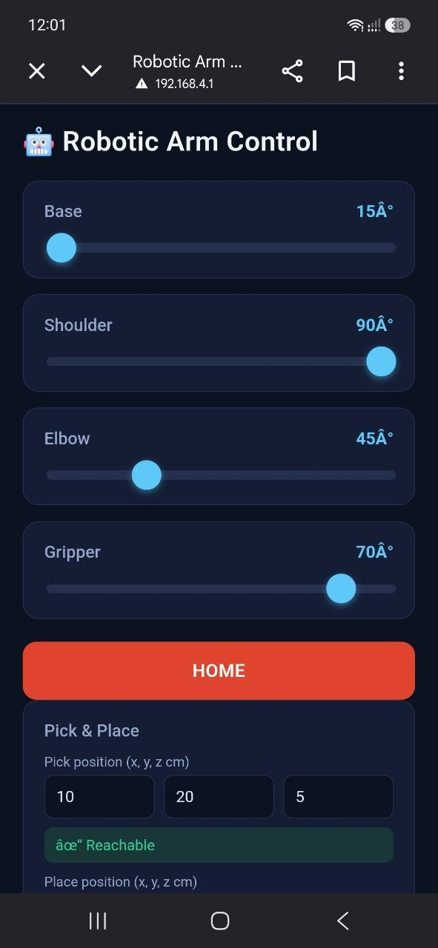
Documentation/photo_2026-09-11_12-02-32.jpg
