FarahnazAzimi/Blue-Arm/Documentation/photo_2026-09-11_12-04-04.jpg

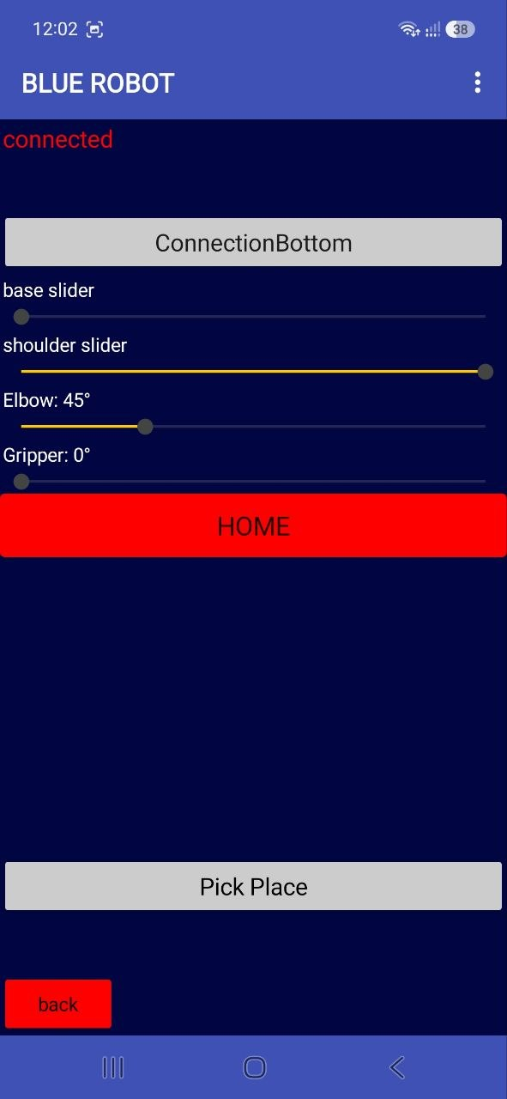
Documentation/photo_2026-09-11_12-04-04.jpg
