FarahnazAzimi/Blue-Arm/Documentation/photo_2026-09-12_00-07-19.jpg

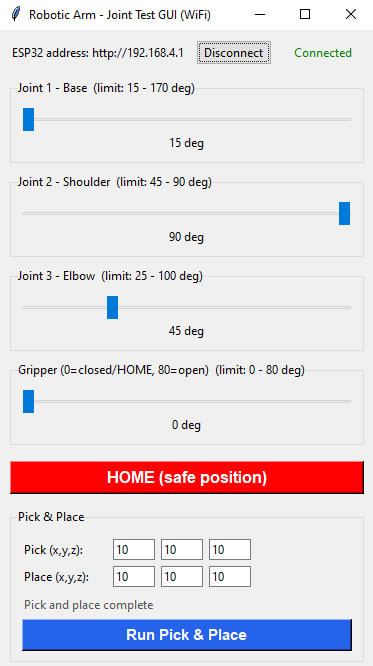
Documentation/photo_2026-09-12_00-07-19.jpg
