FarahnazAzimi/Blue-Arm/Documentation/Robot_image/20260911_101521.jpg

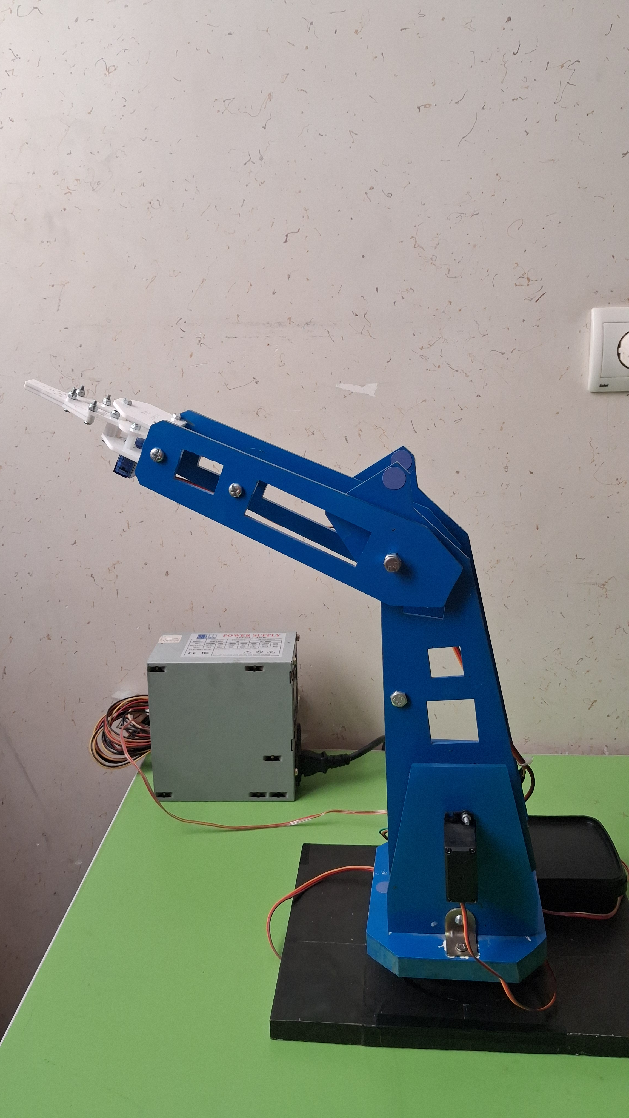
Documentation/Robot_image/20260911_101521.jpg
