FarahnazAzimi/Blue-Arm/Documentation/Robot_image/20260911_165605.jpg

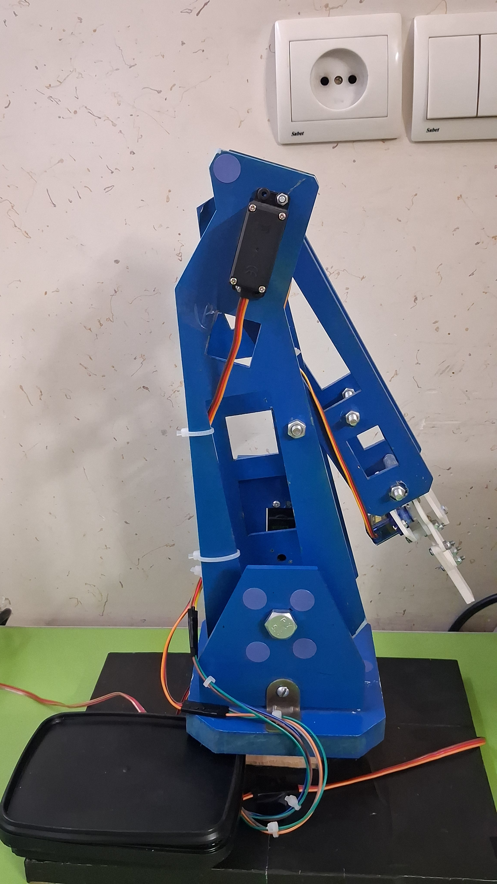
Documentation/Robot_image/20260911_165605.jpg
